tcort/va2epr-tnc/website/va2epr-tnc/va2epr-tnc.png

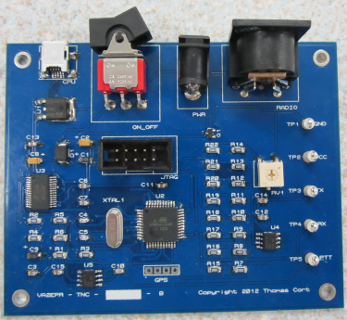
website/va2epr-tnc/va2epr-tnc.png
