tcort/va2epr-tnc/documents/Project Proposal Presentation.pptx

## Terminal Node Controller Final Project

Thomas Cort

[Populated PCB]

## Motivation

- Learning about digital communications.
- Building a device that I will use.
- Sharing my design and software with others.
- Improving on existing technology.
- Passing the course and graduating.

## Outline

- Introduction
- Background Information
- High Level Block Diagram
- Schematic
- Layout
- Milestones
- Statement of Feasibility
- Questions

## Introduction

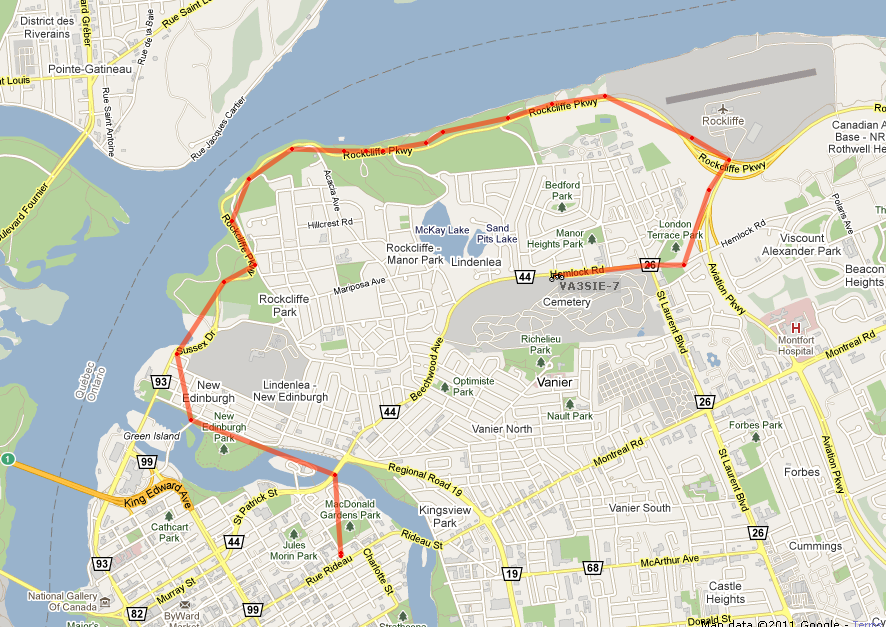
[picture p2: figure]
APRS Map of my bicycle trip...

Position Tracking System

## Background Information

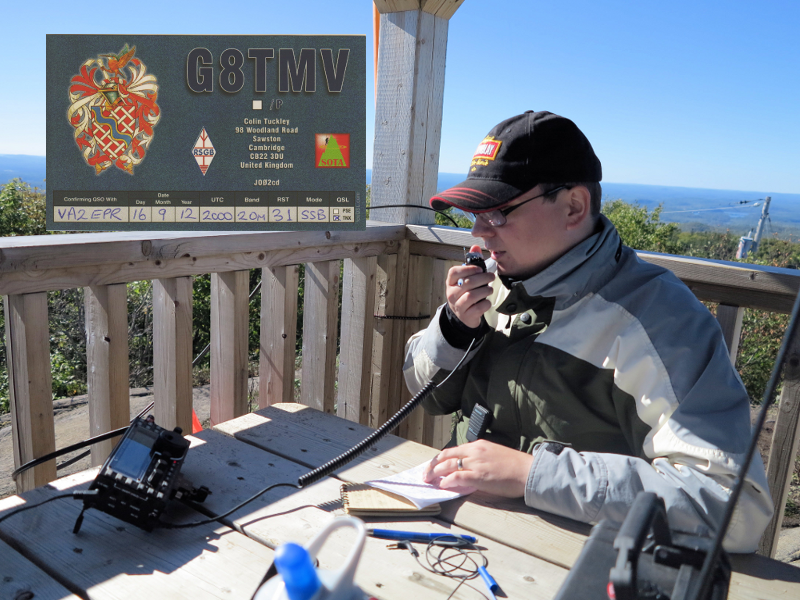
[picture p3: figure]

Amateur Radio

## Background Information

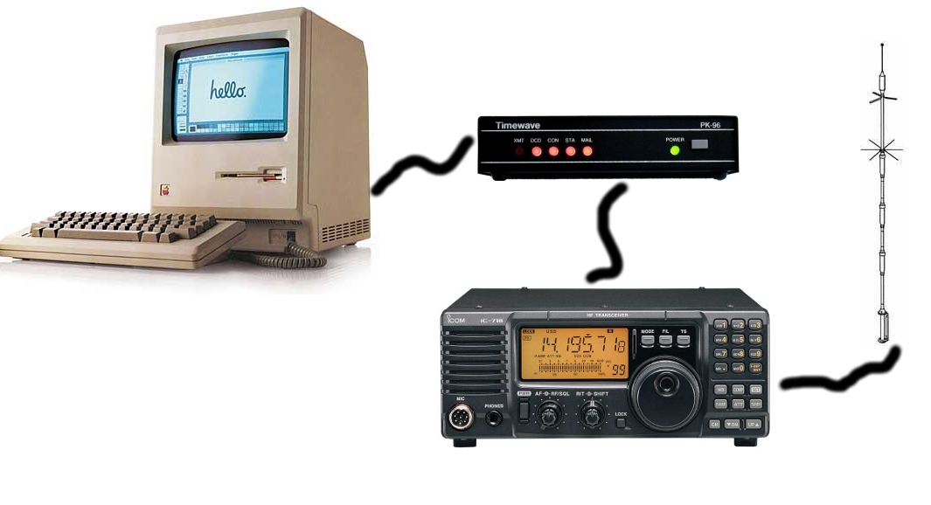
[picture p4: figure]

Packet Radio Terminal Node Controllers

## Background Information

Packet Radio Networks for Position Reporting
- Network – APRS
- Data link – AX.25
- Physical – Bell 202 (1200 Baud AFSK NRZI)

## Goals

- Modern
- Reliable
- Low-cost
- Easy to use
- Open design
- Small form factor
- Portable version

## High Level Block Diagram

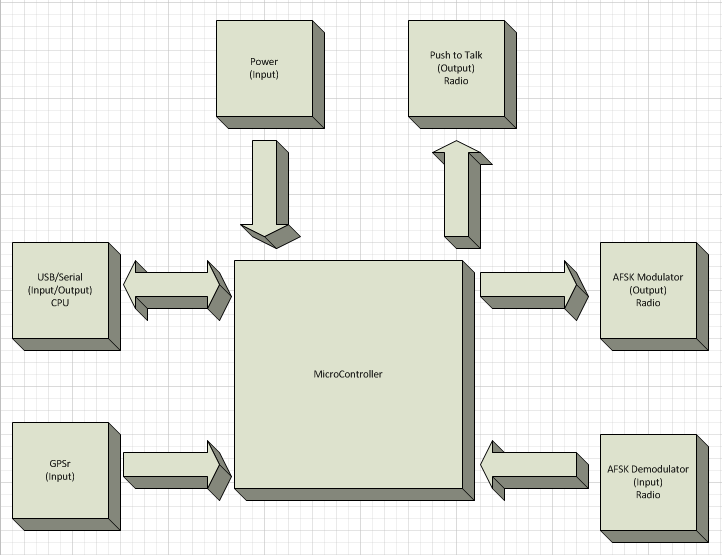
[picture p5: figure]

## Schematic

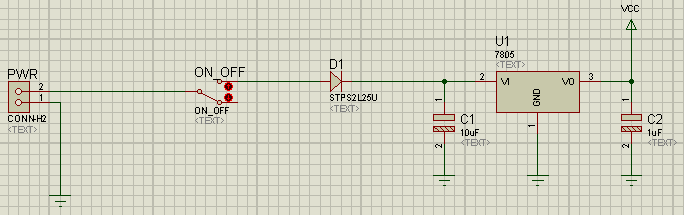
[picture p6: figure]
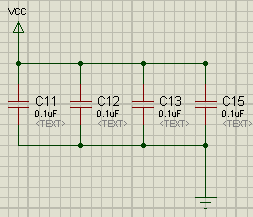
[picture p7: figure]
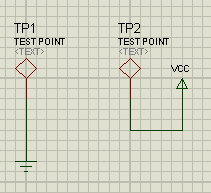
[picture p8: figure]

## Schematic

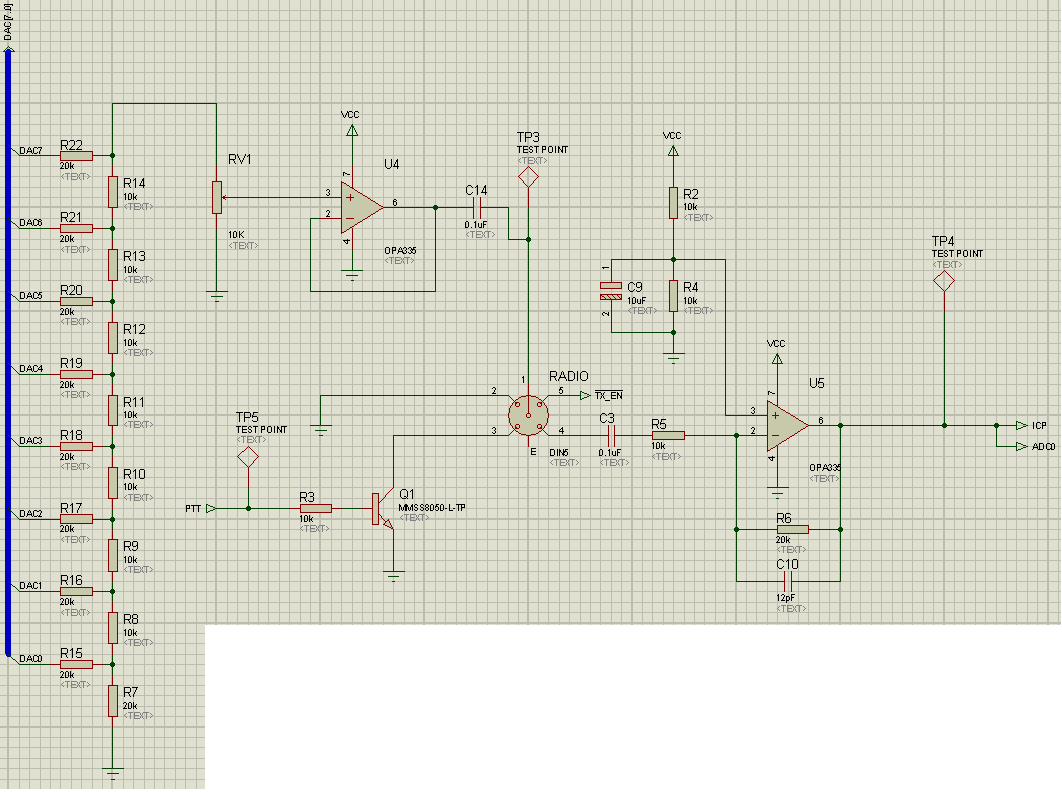
[picture p9: figure]

## Schematic

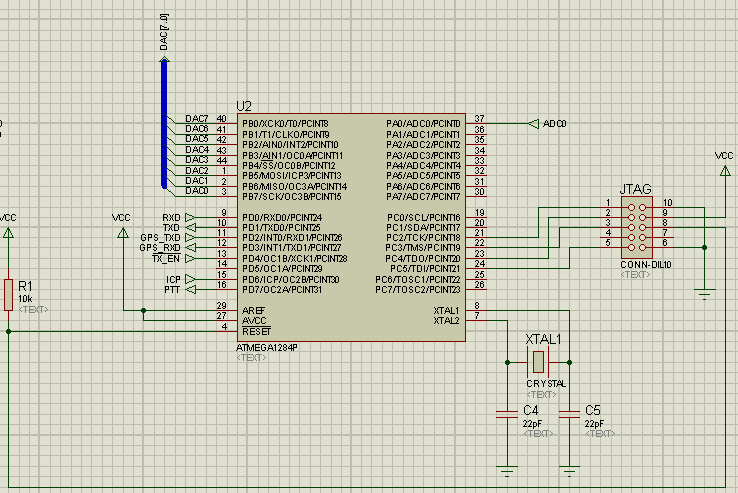
[picture p10: figure]
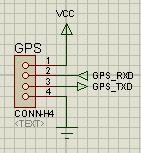
[picture p11: figure]

## Schematic

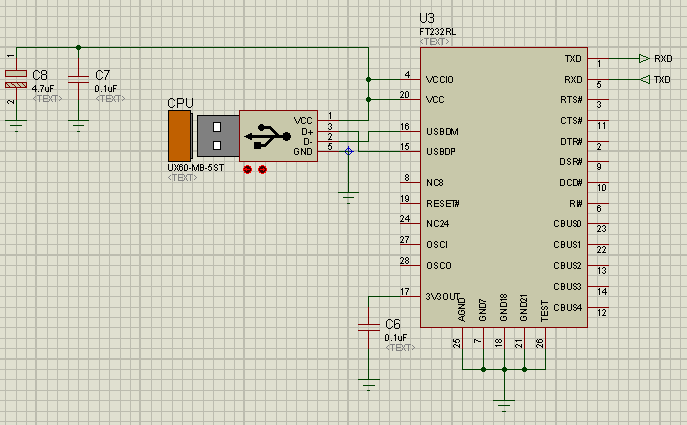
[picture p12: figure]

## Layout

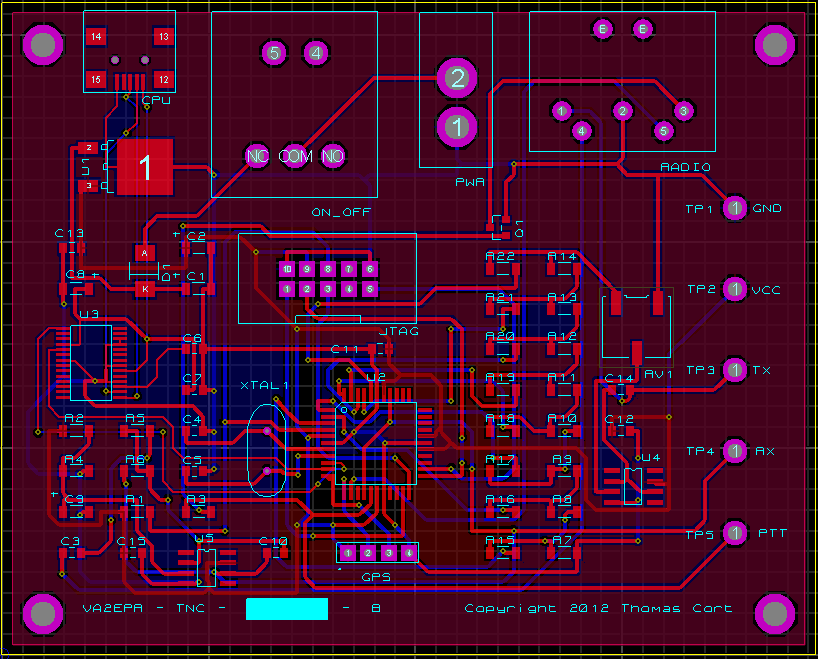
[picture p13: figure]

## Milestones

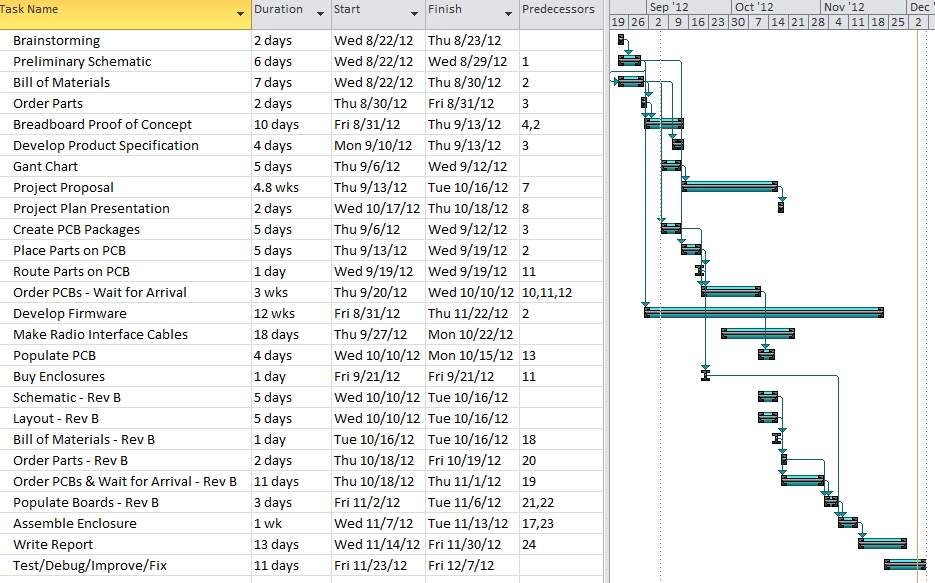
[picture p14: figure]

## Statement of Feasibility

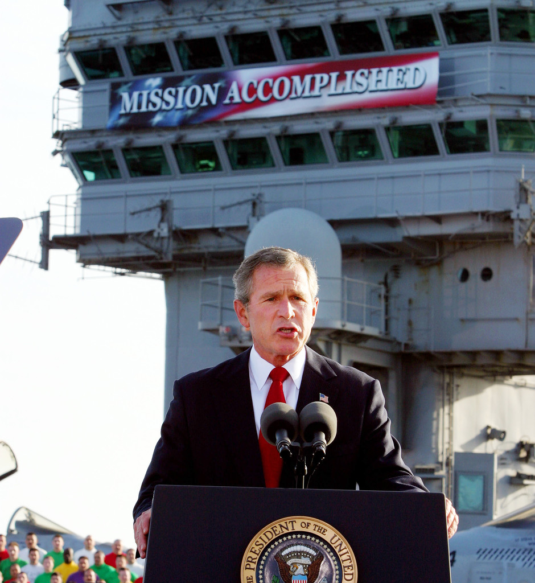
[picture p15: figure]

## Questions?

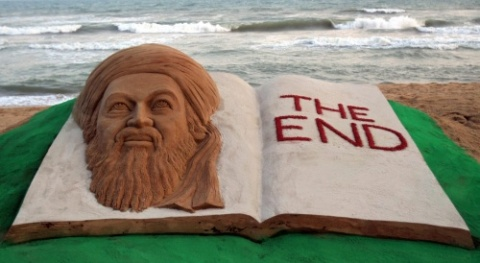
[picture p16: figure]
