tcort/va2epr-tnc/documents/Proposal.odt

Thomas Cort

August 29, 2012

Final Project

I propose developing a Terminal Node Controller (TNC). A TNC is a radio modem; the device is connected to a computer and a radio. Its purpose is to modulate and demodulate signals in order to connect an Amateur Radio operator's computer to packet radio networks. Packet radio networks are useful for keyboard to keyboard communications (chat / instant messaging), reading/posting messages (e-mail / news), emergency communications when normal communications mediums are down, beaconing / receiving position and weather information, and much more. Just within the national capital region there are several weather stations, bulletin board systems, and many other fixed and mobile packet radio nodes. The international space station is even equipped with its own terminal node controller. There are several shortcomings which exist in current terminal node controllers. Improving on those designs is my motivation for this project. The goal of this project is to build a modern reliable low-cost easy to use terminal node controller in a small form factor. I plan on building 2 TNCs, one will be portable. The portable version will have an integrated GPS and periodically beacon its position using the Automatic Packet Reporting System (APRS) protocol. The non-portable version will connect to a computer and perform normal TNC functions (receiving beacons, connecting to other systems, accepting mail, etc).

Terminal Node Controllers operate at the lowest layers of the ISO stack. At the physical level, TNCs implement the Bell 202 Modem standard to send and receive data to and from a radio. The radio itself is responsible for transforming the audio input and output into radio frequency signals. The Bell 202 Modem standard is simply Audio Frequency Shift Keying (AFSK) at 1200-baud with continuous phase using 1200 Hz and 2200 Hz tones. This scheme is also used in North America to transmit telephone caller data over the public switched telephone network to call display systems. In amateur radio, non-return to zero inverted (NRZI) encoding is used. A 1 is encoded as a change in frequency, and a 0 is encoded as no change in frequency. NRZI is used in USB (Mode 1). The interface to the computer is left up to the implementer, but it has traditionally been RS232 (serial). At the data-link layer, computers can send and receive protocol frames to and from the TNC via the KISS protocol, a modified version of Serial Line Internet Protocol (SLIP). The KISS encapsulation is stripped away by the TNC and just the raw frames are sent out over the air. The frames are implemented using the AX.25 protocol. AX.25 is derived from the X.25 protocol with some changes to accommodate radio networks. While in principle AX.25 supports nearly all network layer protocols including Internet Protocol, in practice most communications happen through raw text data sent via AX.25. However, several application layer protocols such as Automatic Packet Report System (APRS) do exist and are in common use. Some TNCs implement AX.25 and can function without a computer by using a dumb terminal. Other TNCs implement just the KISS protocol and let a full featured computer deal with AX.25 and higher level protocols.

The terminal node controllers that I am proposing would include a microcontroller to handle encoding and decoding of the AFSK signals, keying the radio, and interfacing with the computer via the KISS protocol. The computer interface would be RS232 serial. That would enable compatibility with third party software. I would implement AX.25 and APRS. I will also provide a graphical user interface on a PC.

The inputs to the TNC would be audio in (RX) from the radio and RS232 from the computer. The audio signals coming in would be AFSK modulated data. The outputs would be the push to talk (PTT) line to key the transmitter, audio out (TX), and RS232. The TX audio would be used to send AFSK modulated data. The serial interface would be used to communicate with the computer to transfer AX.25 frames and query/adjust settings such as transmit delay, slot time, etc. The portable version would also have an integrated GPS as an input.

In terms of processing, the microcontroller would handle modulating and demodulating the AFSK signals and interface with the computer using the KISS protocol. The PC would handle the data link layer protocol AX.25 and higher level protocols like APRS. The PC would also provide a GUI. The portable version would implement AX.25 and APRS encoding as well as NMEA decoding in order to be able to transmit its location.

The total project could be demoed in the following way: a person could take the portable version and a hand held radio out for a walk in Gatineau park, and the stationary TNC could be connected to a computer and radio in a classroom to display where the person is on a map. The stationary TNC could also be demoed by connecting to a radio BBS or leaving a message on another amateur’s TNC.
