tcort/va2epr-tnc/documents/BuildAndTestProcedure.rtf

Build and Test Procedures
1) Populate all test points: TP1, TP2, TP3, TP4, and TP5.
2) Check for shorts between all test points.
3) Install the USB Mini B connector labelled CPU. Make sure the posts are correctly seated in the holes. Solder 4 corners first, then solder pins. Check for shorts between the 2 outter pins (1 and 5).
4) Connect a computer to the board through the Mini B connector.
5) Measure 5V on pin 20 or pin 4 of U3 or the positive side of C7 or C8.
6) Populate the power section: PWR, ON_OFF, D1, C1, U1, C2
7) Check for shorts between VCC and Ground (TP1 & TP2)
8) Apply 12VDC to PWR, turn ON_OFF to ON, mearsure the voltage across TP1/TP2. It should be 5V. Disconnect power.
9) Populate the PTT section: R3, Q1
11) Populate the decoupling capacitors: C11, C12, C13, C15
12) Populate the RX section: C3, R5, R2, R4, C9, U5, R6, C10
13) Check for shorts between VCC and Ground (TP1 & TP2). Apply a 1Vpp sine wave at 1200Hz to pin 4 of the DIN5 connector (labelled RADIO). Measure the output waveform on TP4 using an oscilloscope. It should show a 4.85Vpp sine wave at 1200 Hz with a 2.5V DC offset.
14) Populate the TX section: R7 to R25, U4, C14
15) Check for shorts between VCC and Ground (TP1 & TP2). If possible, apply a 0V to 5V square wave at 1200 Hz to pin 30 on U2 or the micro side of R22. Measure the output waveform on TP3 using an oscilloscope. It should show a 0.5Vpp square wave at 1200 Hz with no DC offset.
16) Populate the rest of the USB/Serial Interface: C6, C7, C8, U3
17) Populate the microcontroller section: JTAG, U2, R1, XTAL, C4, C5. Hint: pin 1 of JTAG goes to Pin 21 on the micro.
18) Populate any unpopulated parts.
19) Check for shorts between VCC and Ground (TP1 & TP2). Power up briefly. Watch the current meter on the power supply. If there is no smoke, smells, nor heating, then connect a JTAG programmer to the JTAG port and try to program it.
20) Set the fuses
BODLEVEL DISABLED
OCDEN Checked
JTAGEN Checked
SPIEN Checked
BOOTSZ 4096W_F000
SUT_CKSEL FOSC_16KCK_65MS_XOSC_SLOWPWR

21) Program with the test firmware. Check for the expected output at the test points.
