tcort/va2epr-tnc/documents/Diary12.rtf

Final Project Diary #12 Thomas Cort
November 22, 2012
During the preceding week, I assembled two TNC <-> Radio interface cables. I also worked on debugging the firmware for my project. Specifically, I’m trying to fix a problem in the AFSK demodulator where it’s not decoding the data properly. I’ve confirmed that I’m sampling the input signal at the right baud rate by toggling an output pin every time I sample the input. I’ve also double checked my math and the settings for input capture, and I looked at the input to the ICP pin on an oscilloscope. Everything seems okay.
During the next week, I will continue to work on the firmware. I’m going to think over the problem I’m having, and look at some code that someone else wrote to implement a zero-cross detector based AFSK decoder. If that doesn’t yield any good results, I may implement a software based zero cross detector using the ADC.
