tcort/va2epr-tnc/documents/Diary10.rtf

Final Project Diary #10 Thomas Cort
November 8, 2012
During the preceding week, I received my Rev B PCBs. I populated one board and most of another. I ran out of parts for the 2nd. I've ordered additional parts from Digi-key as well as some molex connectors to connect the GPS module to the PCB. I did some testing on the board that I did finish populating. The regulated voltage is a solid 5.00V. I was able to program the board with the AVR Dragon, setting fuses and writing to flash and eeprom. I tested the UART and the AFSK output. I realized that the DAC was wired backwards (LSB first instead of MSB first), so I had to recompute the sine wave table, reversing the bits in each entry. I also drilled a few holes in an enclosure. Lastly, I researched how to demodulate the AFSK signal in software.
During the next week, I will finish populating the second PCB. I will build TNC <-> Radio interface cables using new DIN5 connectors I got from Digi-key. I will also finish drilling the enclosures. After testing the Rev B hardware, I will continue to work on the software and firmware. For the software, I’ll finish up the console class. For the firmware, I’m going to debug my AFSK receive code (or re-write it).
