tcort/va2epr-tnc/documents/Diary11.rtf

Final Project Diary #11 Thomas Cort
November 15, 2012
During the preceding week, I ordered the parts I needed from Digi-key to finish populating the 2nd PCB. I also ordered connectors, sockets, pins, and crimpers to connect the GPS to one of the boards. I tested the 2nd PCB, and there were no assembly errors. In addition, I did a lot of work on the enclosures. I drilled holes to mount the boards, and I made large cut outs so that the power switch and all of the connectors would be accessible from outside the case. Finally, I mounted the boards in the enclosures and did some additional tests (for example, checking that the GPS could obtain a lock and report its position).
During the next week, I will finish building the TNC <-> Radio interface cables using new DIN5 connectors I got from Digi-key. I had worked on one last week, but I made an error. When those are complete, I will be able to do more tests of the firmware and work towards finishing the firmware.
