tcort/va2epr-tnc/documents/Diary9.rtf

Final Project Diary #9 Thomas Cort
November 1, 2012
During the preceding week, I did some work on the GUI software. I worked on that because I need to be able to send “unprintable characters” (e.g. 0xff) from the PC via the USB interface as well as receiver data on the PC and look at it in HEX and ASCII. I couldn’t really find a terminal program that allowed me to do those things, so I began working on a “Console” class that uses the SerialPort classes I wrote last week to present a display that allows a user to input data and view the received data. This will enable me to do a better job testing and debugging the firmware code. It will make things like testing the EEPROM read/write possible. Also, I did a proof of concept for the maps that my GUI will use to display the position of the portable unit. I used the OpenStreetMap’s OpenLayers Javascript library in conjunction with a QWebView widget and some custom HTML, Javascript, and CSS to create a map widget. I also learned how to call Javascript functions from C++; this will be used to manage the position markers on the map. Lastly, I revised my project proposal report and distributed it to the class.
During the next week, I will populate my new printed circuit boards. The Rev B boards should arrive tomorrow. I will build TNC <-> Radio interface cables using new DIN5 connectors I got from Digi-key. After testing the Rev B hardware, I will continue to work on the software and firmware. For the software, I’ll finish up the console class. For the firmware, I’m going to debug my AFSK receive code. It’s written but it doesn’t really work except for sometimes finding the AX.25 frame delimiter flag. I am working towards being able to transmit a position report as well. For that, I will need to finish implementing AFSK TX.
