tcort/va2epr-tnc/documents/Diary8.rtf

Final Project Diary #8 Thomas Cort
October 25, 2012
During the preceding week, I ordered Rev B PCBs from iTead Studio. They shipped out today. I ordered the additional parts from Digi-key, potentiometers and better DIN5 connectors. Those parts have arrived. I worked on the build system for the firmware too. I added makefile targets to build an eeprom image, write the eeprom, read the fuses, and write the fuses. Additionally, I wrote some C++ classes for doing serial communications in Linux and Windows. I tested receiving data from the micro on Linux and Windows.
During the next week, I will continue to work on the firmware. I’m going to debug my AFSK receive code. It’s written but it doesn’t really work except for sometimes finding the AX.25 frame delimiter flag. I am working towards being able to transmit a position report as well. For that, I will need to finish implementing AFSK TX.
