tcort/va2epr-tnc/documents/Diary7.rtf

Final Project Diary #7 Thomas Cort
October 18, 2012
During the preceding week, I completed the project proposal report document and the project proposal presentation slides. I did additional testing of the circuits on the PCB. I also connected the GPS receiver to the board. I echoed the output from the GPS to the other UART, and I observed the output on a PC. I researched the APRS protocol to see what information I will need to encode for position report packets. I did some work on the firmware. I implemented checksum checking for NMEA 0183 (the data format for stuff coming out of the GPS). I also wrote a function to extract the coordinates from GGA and RMC NMEA sentences. I have an AX.25 checksum function written too. Additionally, I did some layout work on my Rev B PCB. I’ve made some improvements and fixes. Lastly, I researched connectors for the GPS module as I noticed the thin wires probably wouldn’t hold up for very long if directly soldered to the board with no strain relief.
During the next week, I will order Rev B PCBs from iTead Studio. I will also order a few additional parts from Digi-key as I will be short on some parts and have a few new parts to buy (potentiometers and better DIN5 connectors). I will continue to work on the firmware. I am working toward being able to transmit a position report. I will need to develop stripped down implementations of AX.25 and APRS for that as well as finish implementing AFSK TX.
