tcort/va2epr-tnc/documents/Diary6.rtf

Final Project Diary #6 Thomas Cort
October 11, 2012
During the preceding week, I completed the first draft of the Project Proposal Report. I also received the printed circuit boards from iTead Studio. I populated a board with components and performed some tests. I discovered an issue with the voltage regulator package, the pinout is wrong. I was able to leave off the power supply section and populate the rest of the board, supplying power through the VCC/GND test points from a bench supply. Here is a summary of the testing I’ve done: plugged in a USB cable and the computer detected the FTDI chip, applied a signal to the RX input and looked at the RX test point (it looked good), I used the JTAG port to read/program the chip and fuses, I tested the serial interface, and I also tested the DAC output. During the assembly and test process I identified other things that can be improved on the board. For example, the silk screen for the polarized capacitors lacks polarity indicators. I’ve started a document to enumerate the changes I have in mind for revision B.
In my previous journal entry I neglected to mention that I had worked on the radio interface cables. That didn’t go so well. I chose the DIN5 connectors based on price, and it turns out that they were garbage. The plastic that holds the pins in place has a very low melting point, and the pins are so big they act like heat sinks which causes the plastic to melt before the pin is hot enough for the solder to flow. I’m planning on purchasing higher quality DIN5 connectors (or just buying full cable assemblies) in my next Digi-key order.
During the next week, I will finalize the project proposal report document and create the presentation slides. I will continue testing the PCB. I want to make sure I capture all of the mistakes from the first revision before spinning another board. Then, I will make a revision B board and order new PCBs and a few parts.
