tcort/va2epr-tnc/documents/Diary5.rtf

Final Project Diary #5 Thomas Cort
October 4, 2012
During the preceding week, I worked mainly on documentation and a bit on firmware. I’m nearly finished the Project Proposal Report. I also am preparing for when my PCBs arrive. I wrote a build and test procedure for populating the board. Lastly, I worked on ‘test’ firmware that exercises the different circuits. It will output a specific pattern on the TX pin, toggle the PTT pin on and off periodically, send a test message through USART, and output the frequency of the signal being received on the RX pin.
During the next week, I will be testing the GPS UART interface. I will also work on debugging the firmware for receiving data. I will finish the project proposal report and presentation. I will also finish the test firmware while waiting for my PCBs to arrive.
