tcort/va2epr-tnc/documents/Diary4.rtf

Final Project Diary #4 Thomas Cort
September 27, 2012
During the preceding week, I did more work on the firmware. I developed code to decode the incoming AFSK signals and output the bytes through the UART interface using the KISS protocol. I tested the code and found that it isn't working as expected. Some bytes are decoded correctly, but a lot aren't. From the testing I've done it's either a timing issue, a byte order issue, or my tollerances/thresholds for determining when a specific tone is present are too tight. My PCBs have shipped from iTead Studio. I also ordered enclosures from TenTec; those are on the way as well. Finally, I wrote an additional 10 pages of the project specification document.
During the next week, I will be testing the GPS UART interface. I will also work on debugging the firmware for receiving data. I will continue work on the a project plan document, hopefully finishing it. Finally, I will come up with a test plan / assembly procedure for my PCB so that if there are errors, I know early (i.e. before everything has been soldered) and don't fry any chips.
