tcort/va2epr-tnc/documents/Diary3.rtf

Final Project Diary #3 Thomas Cort
September 20, 2012
During the preceding week, I did some work on the firmware. I implemented CSMA/CA as well as persistent configuration storage with EEPROM. I tested the output voltage of a Kenwood TH-22AT radio and researched interfacing with the radio to ensure that it will be compatible with my project. I also completed my PCB layout and ordered the boards from iTead Studio. In addition, I wrote the introduction section of the project specification document. Finally, I updated my Gantt chart to reflect my progress.
During the next week, I plan on testing the UART sections of my circuit; I will be testing the GPS UART interface and computer UART interface via the FT232RL chip. I will also work on the firmware for receiving data. I will continue work on the a project plan document. Lastly, I will go shopping for enclosures.
