tcort/va2epr-tnc/documents/Diary2.rtf

Final Project Diary #2 Thomas Cort
September 12, 2012
During the preceding week, I created a Bill of Materials (BOM) in Proteus ISIS. The BOM is complete with Digi-key part numbers and costs which are totaled at the bottom. I assigned packages to parts as well. I also placed parts in Proteus ARES and created some footprints. I'm almost done the PCB layout, mounting holes and routing remain (the autorouter can route everything in it's current state). After that I will verify pinouts against the datasheets and check footprints with a print-out and actual parts. I continued bread boarding and developing firmware. I tested some of the main sections of the circuit. I was able to use input capture to determine an incoming audio signal’s frequency and turn on one LED for 1200 Hz and another for 2200 Hz. I was also able to generate sine waves at those two frequencies, though I may need to increase the number of samples to get a better approximation of a sine wave. Additionally, I tested the transistor I plan on using to control the Push-to-Talk (PTT) line by using it to turn on and off an LED. Lastly, I developed a Gant Chart as part of my project plan.
During the next week, I plan on testing the UART sections of my circuit; I will be testing the GPS UART interface and computer UART interface via the FT232RL chip. Assuming the hardware is working as expected, I will complete my PCB layout. I will also work on the product specification document, a project plan document, and a project plan presentation. Lastly, I will verify the input/output voltage levels of several radios to ensure that my interface will work correctly.
