tcort/va2epr-tnc/documents/Diary1.rtf

Final Project Diary #1 Thomas Cort
September 5, 2012
During the preceding week, I completed the first draft of my schematic. I ordered the parts needed for bread boarding the circuit as well as parts and tools for the final board. I also ordered materials for making cables to interface with a radio. The parts arrived, and I began bread boarding parts of the circuit. I soldered some SMT only parts to breakout boards. I got the power stage built, and I wired up the microcontroller. I was able to set the fuses and program it with an AVR Dragon in AVR Studio. I developed some sine wave generation code as well as a utility to pre-compute sine wave tables. I setup an R-2R ladder on the breadboard to test it. The code needs some debugging as I'm not getting any output yet.
During the next week, I plan on testing more sections of my circuit. After completing a proof of concept (can generate sine waves, can capture a sine wave, can turn on/off a transistor, etc.), I will finalize the schematic and bill of materials. Then, I’ll move on to the PCB layout. I will also develop a project plan during this time.
