tcort/va2epr-tnc/documents/Diary15.rtf

Final Project Diary #15 Thomas Cort
January 29, 2012
During the preceding week, I went through the firmware squashing bugs and adding comments. I also added a feature to allow the PC to retrieve the configuration settings from my device. I did some work on the PC software as well. I’ve made some improvements to the console, and I made a few updates to correspond with some changes I made to the firmware.
During the next week, I will work on finishing up the firmware that will be used for the base station (i.e. without APRS and AX.25), and I will do some testing. For the testing, I need to work on the PC software. I need to connect my SerialPort implementation to code that will process the data. After that I’ll begin testing with pre-recorded signals. If the code works, I’ll move on to the firmware for the portable version. For that I need to implement a minimal AX.25 and APRS stack.
