tcort/va2epr-tnc/documents/Diary16.rtf

Final Project Diary #16 Thomas Cort
February 5, 2013
During the preceding week, I did some research and found some software libraries that will make my life easier. The Finnish APRS Parser library will allow me to parse raw packets on the PC that come from my hardware. I also found how to configure the kernel device driver for KISS TNCs and how to use the AX.25 library. In addition, I decided to use QextSerialPort for serial port communications from Qt. I had originally written my own library, but QextSerialPort has many more features and is much more flexible. I have done the initial work to convert my PC software to use QextSerialPort, but more work remains on that front. I also did some clean-up of the console class, added a splash screen when the program is loading, and added doxygen documentation generation to the build system.
During the next week, I will work on finishing up the firmware that will be used for the base station (i.e. without APRS and AX.25), and I will do some testing. For the testing, I need to work on the PC software. I need to put code behind the buttons that read/write the configuration information to my hardware, and I need to finish up the code that displays the serial data in the GUI’s console. After that I’ll begin testing with pre-recorded signals. If the code works, I’ll move on to the firmware for the portable version. For that I need to implement a minimal AX.25 and APRS stack.
