tcort/va2epr-tnc/documents/Diary17.rtf

Final Project Diary #17 Thomas Cort
February 12, 2013
During the preceding week, I did more work on the GUI software for the PC. I wrote the code that backs the Connect and Disconnect buttons so that the serial port can connect to my hardware. I did some code clean up and some commenting. I also added Tool Tips to the fields in the configuration form. Lastly, I wrote some Javascript to add markers to the map. I would have done some testing of the serial port communications and implement read/write functions, but we only had half of a class on Tuesday because of some promotional thing for the college.
During the next week, I will work on finishing up the firmware that will be used for the base station (i.e. without APRS and AX.25), and I will do some testing. For the testing, I need to implement read and write for the serial port in the PC software. After that I’ll begin testing with pre-recorded signals. If the code works, I’ll move on to the firmware for the portable version. For that I need to implement a minimal AX.25 and APRS stack.
