tcort/va2epr-tnc/documents/Diary18.rtf

Final Project Diary #18 Thomas Cort
February 19, 2013
During the preceding week, I worked on some TODO items that were still left in the firmware. Most notably, I added some functions to get the time from the GPS and compare the time to another time. This will be used in the portable version to determine whether it’s time to beacon again or wait. I also worked on the transmit code and buffer code. I cleaned up some code in the GUI, implemented an interface to write to the serial port, added code to display the bytes read from the serial port, and corrected some minor typos. I was successfully able to connect to my hardware from my GUI.
During the next week, I will work on the configuration part of the GUI (i.e. the part that reads/writes configuration data from/to my hardware). I will test the code with various values to make sure that it works and that the settings persist after power cycling the hardware. After that’s working, I will do testing of the AFSK transmit and receive code.
