tcort/va2epr-tnc/documents/Diary13.rtf

Final Project Diary #13 Thomas Cort
November 29, 2012
During the preceding week, I continued to work on the firmware for my project. It’s over 2000 lines of code so far! The AFSK receive code isn’t done yet, but it’s improving in accuracy. I’ve started working on the AFSK transmit code. I can vary the output signal frequency while keeping the phase continuous; the signal looks good on the scope. Lastly, I wrote and tested a function to detect if the GPS is connected (i.e. if the device is configured as the portable version or the base station version).
During the next week, I will continue to work on the firmware. The following is a list of features that need to be implemented for the firmware to be feature complete:
• AFSK TX
o I need to work on the TX buffer management code
• AFSK RX
o I need to finish debugging the RX code
• Obtaining position information
o GPS USART is working, and I’ve written/tested a NMEA parser.
o I need to write code to buffer the incoming data and call the parser.
• Ability to TX position reports
o I need to implement a small part of AX.25 for framing
▪ So far I’ve written the CRC function
o I need to implement a small part of APRS
I probably won’t finish everything in the coming week, but I’ll continue to work on the code over the christmas break.
