tcort/va2epr-tnc/documents/Diary14.rtf

Final Project Diary #14 Thomas Cort
January 22, 2012
During the preceding week, I went through my project files to take stock of my current progress. Then, I updated my project plan and Gantt chart. I began working on finishing up the firmware. I think I have the AFSK RX code fixed; I just need to test it with real AFSK signals. I also wrote buffer management code for grabbing data off of the GPS.
During the next week, I will work on finishing up the firmware that will be used for the base station (i.e. without APRS and AX.25). For that, I need to work on the TX buffer management code. After that I’ll begin testing with pre-recorded signals. If the code works, I’ll move on to the firmware for the portable version. For that I need to implement a minimal AX.25 and APRS stack.
