tcort/va2epr-tnc/hardware/VA2EPR-TNC.PDF

## PWR

## ON_OFF

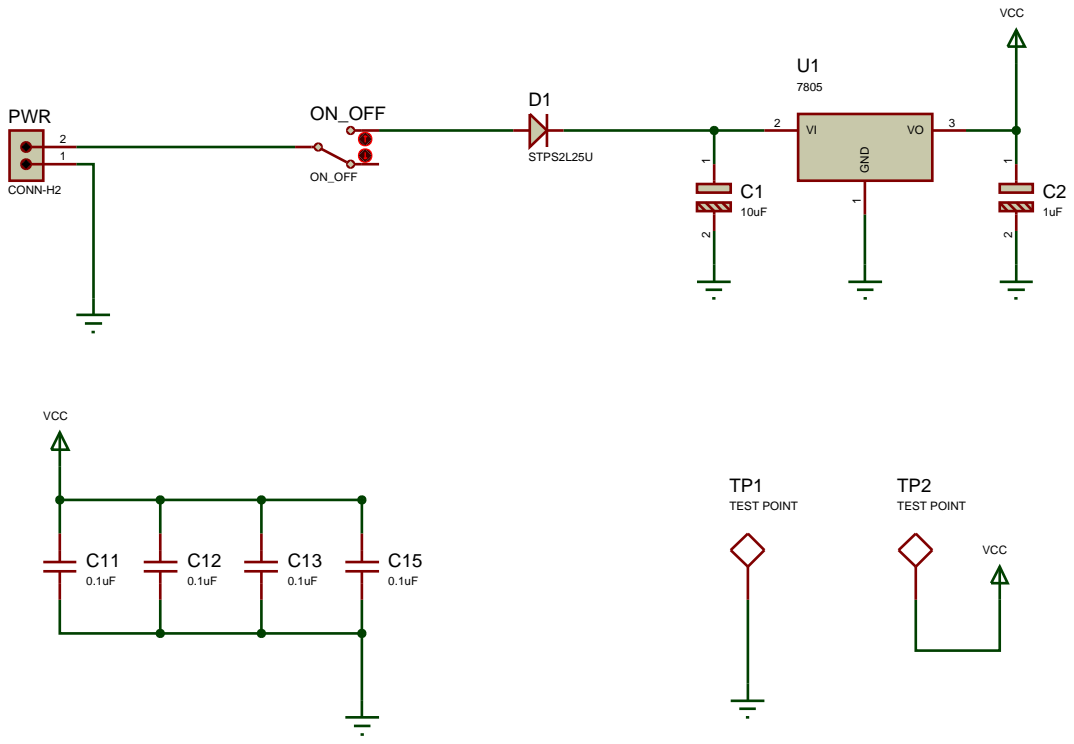
[picture p27: page 1]

R2

R14

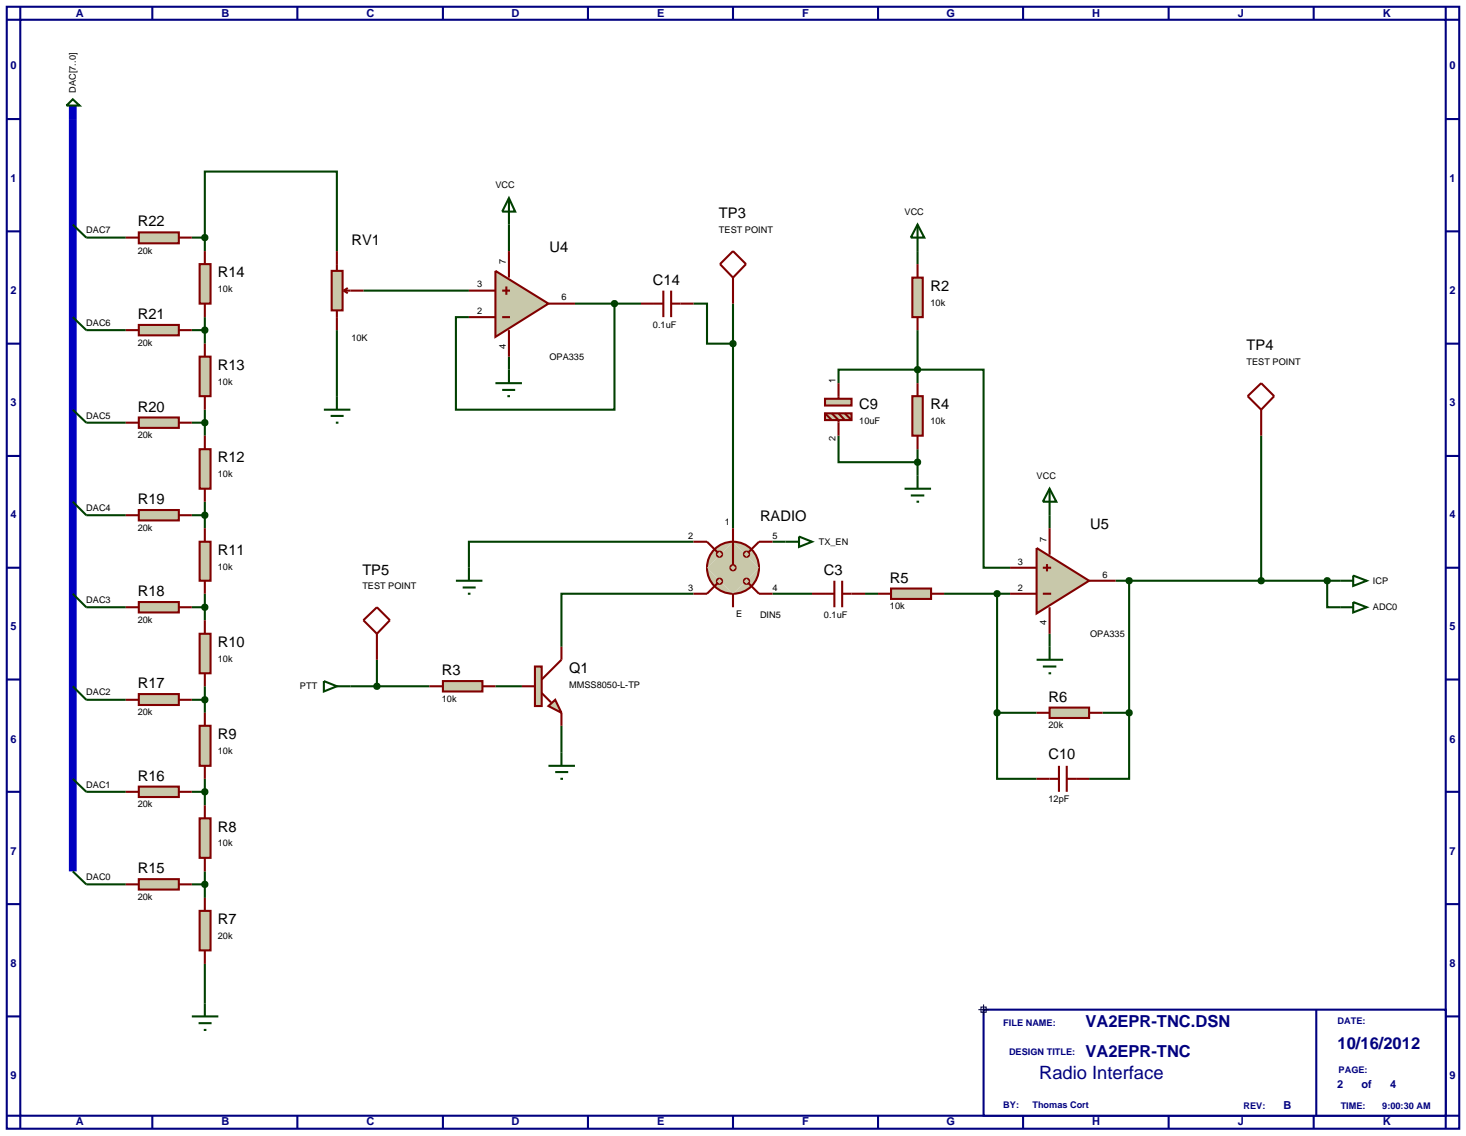
[picture p28: page 2]

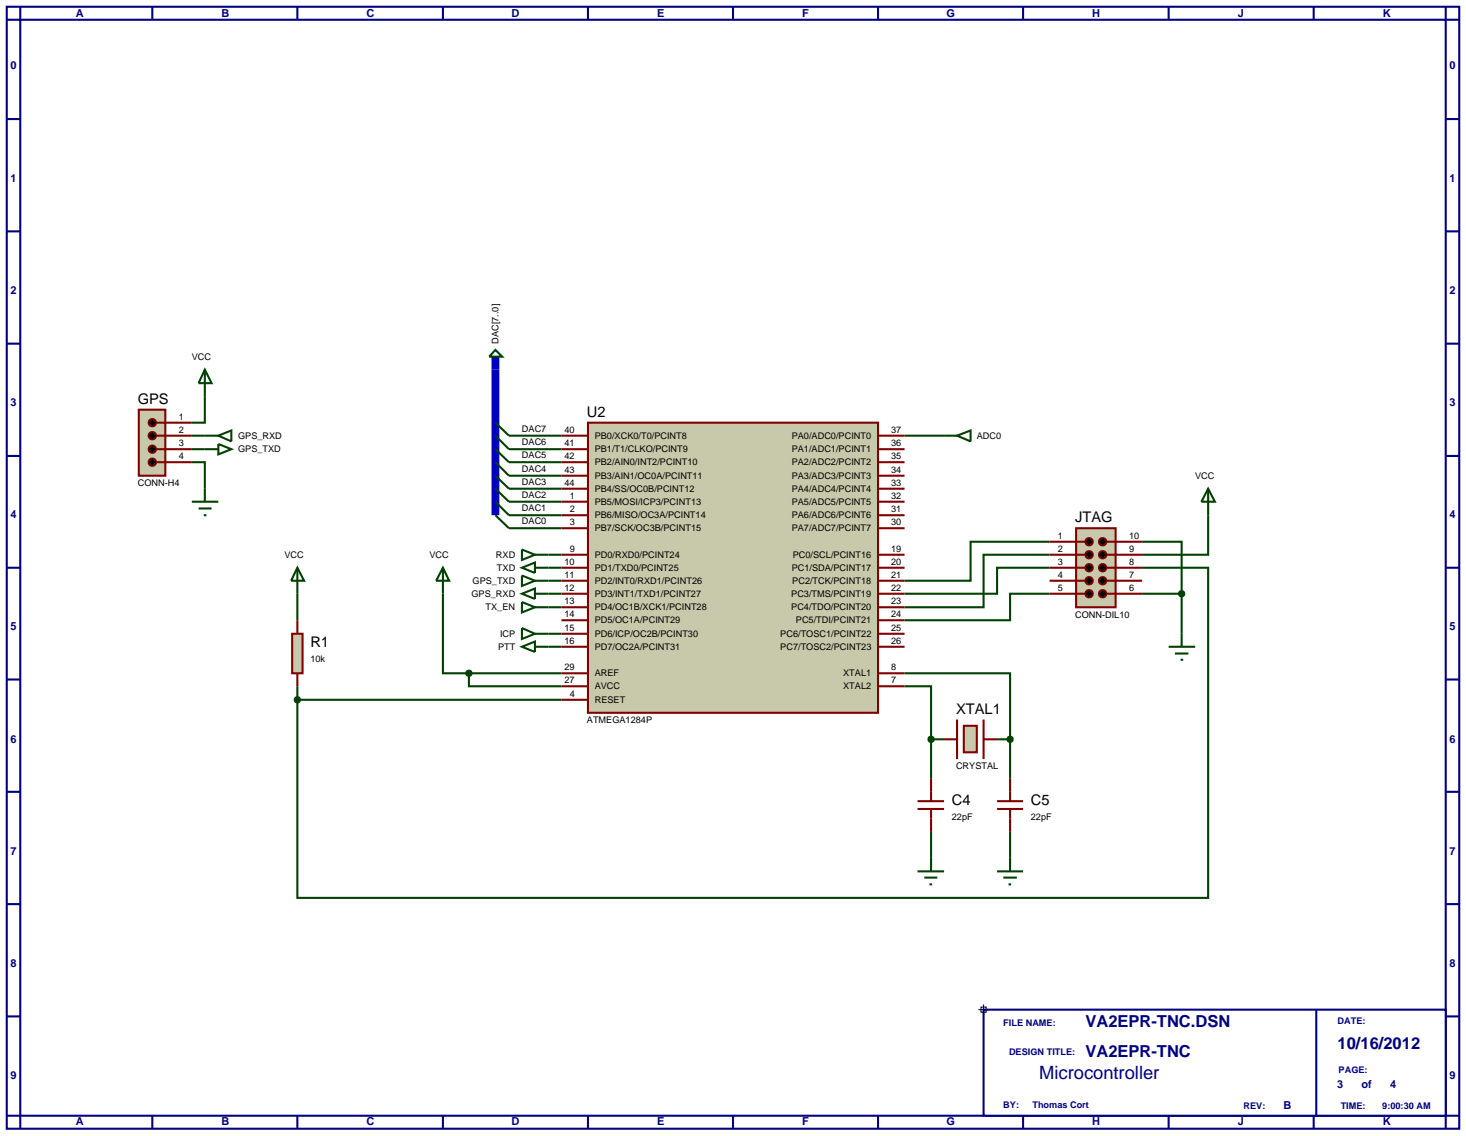
[picture p29: page 3]
FILE NAME:; DATE:; VA2EPR-TNC.DSN; Microcontroller; DAC7 DAC6 DAC5 DAC4 DAC3 DAC2 DAC1 DAC0; PC6/TOSC1/PCINT22; PC5/TDI/PCINT21; PC4/TDO/PCINT20; PC3/TMS/PCINT19; PC2/TCK/PCINT18; PC1/SDA/PCINT17; PC0/SCL/PCINT16; AVCC 27; AREF 29; PC7/TOSC2/PCINT23; PA6/ADC6/PCINT6; PA5/ADC5/PCINT5; PA4/ADC4/PCINT4; PA3/ADC3/PCINT3; PA2/ADC2/PCINT2; PA1/ADC1/PCINT1; PA0/ADC0/PCINT0; PA7/ADC7/PCINT7; PB6/MISO/OC3A/PCINT14 2; PB5/MOSI/ICP3/PCINT13 1; PB4/SS/OC0B/PCINT12 44; PB3/AIN1/OC0A/PCINT11 43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

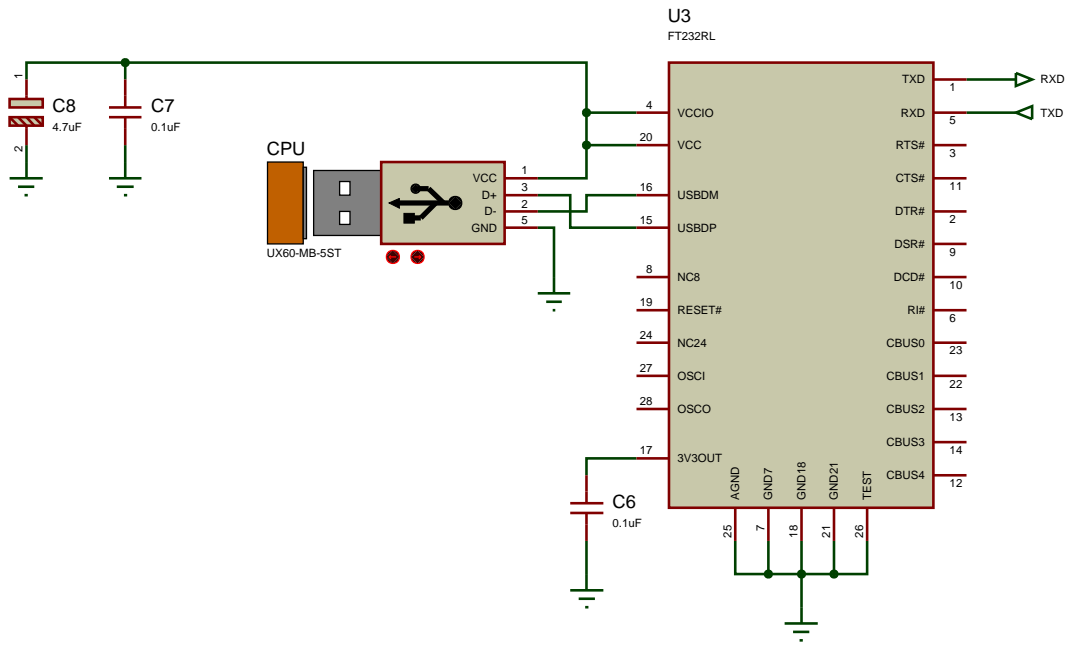
[picture p30: page 4]
FILE NAME:; DATE:; VA2EPR-TNC.DSN; Computer Interface; VCC; GND; CPU; VCCIO 4; VCC 20; USBDM 16; USBDP 15; RESET# 19; OSCI 27; OSCO 28; 3V3OUT 17 AGND 25; GND7; GND18 18; GND21 21; TEST 26; TXD; RXD; RTS#; CTS#; DTR#; DSR#; DCD#; CBUS0; CBUS1; CBUS2; CBUS3; CBUS4
