tcort/va2epr-tnc/(list of files, drawings)

Other design files:
hardware/va2epr-tnc-cables.DSN
hardware/VA2EPR-TNC.DSN
hardware/VA2EPR-TNC.LYT
website/va2epr-tnc/VA2EPR-TNC.DSN
website/va2epr-tnc/VA2EPR-TNC.LYT
