tcort/va2epr-tnc/firmware/gps.c

/*
 * va2epr-tnc firmware - terminal node controller firmware for va2epr-tnc
 * Copyright (C) 2012, 2013 Thomas Cort <linuxgeek@gmail.com>
 *
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
 * You should have received a copy of the GNU General Public License
 * along with this program.  If not, see <http://www.gnu.org/licenses/>.
 */

/*
 * The GPS module being used in this project outputs data according to
 * NMEA0183 V2.2. It supports the following sentences:
 *
 *   GGA ~ Global Positioning System Fix Data. Time, Position and fix related data for a GPS receiver
 *   GSV ~ Satellites in view
 *   GSA ~ GPS DOP and active satellites
 *   RMC ~ Recommended Minimum Navigation Information
 *   VTG ~ Track Made Good and Ground Speed (optional)
 *   GLL ~ Geographic Position Latitude/Longitude (optional)
 *
 * From what I've read, the GPS module continuously outputs
 * GPGGA, GPGSA, GPGSV, and GPRMC sentences in NMEA mode. From what I observed,
 * not all sentences appear all of the time. For example, GPGSV isn't sent
 * when no satellites are in view.
 *
 *
 * When I plugged it in for the first time I got this about every second...
 *
 *   $GPGGA,000425.035,0000.0000,N,00000.0000,E,0,00,,0.0,M,0.0,M,,0000*46
 *   $GPGSA,A,1,,,,,,,,,,,,,,,*1E
 *   $GPGSV,1,1,00*79
 *   $GPRMC,000425.035,V,0000.0000,N,00000.0000,E,,,150209,,,N*7C
 *
 * When no satellites were in view, there were no $GPGSV sentences.
 *
 * Coordinates use the WGS 84 DATUM
 *
 * Ports and Peripherals Used
 * --------------------------
 *
 * USART1 (Connected to the GPS)
 *
 * PD2 (RXD)
 * PD3 (TXD)
 */

#include <avr/io.h>
#include <avr/interrupt.h>
#include <string.h>
#include <util/delay.h>

#include "uart.h"
#include "gps.h"
#include "nmea.h"

/* Size of the receive buffer (should be big enough for 1 sentence) */
#define GPS_BUFFER_SIZE (128)

/*
 * Input buffer for GPS data. It should hold an NMEA sentence.
 */
unsigned char gps_buffer[GPS_BUFFER_SIZE];

/*
 * Current location in the gps_buffer to put the next byte.
 */
unsigned char gps_buffer_index;

/*
 * Coordinates
 */
struct nmea_coordinates coords;

/*
 * Type of the sentence stored in gps_buffer
 */
enum nmea_sentence_type gps_buffer_type;

/*
 * Simple State Machine for getting an NMEA sentence from a stream.
 *
 *  SEARCHING - looking for start of sentence '$'
 *  LOADING - copying data into gps_buffer_type[]
 *  DONE - gps_buffer_type[] has a sentence in it, ignore input until manual state change.
 */
enum gps_state { SEARCHING = 0, LOADING = 1, DONE = 2 } current_state;

/*
 * Initialize the GPS interface
 */
void gps_init(void) {

	/* 4800 baud */
	UBRR1H = (GPS_UBRR_VAL >> 8);
	UBRR1L = (GPS_UBRR_VAL & 0xFF);

	UCSR1C |= (1 << UCSZ10) | (1 << UCSZ11);

	current_state = DONE;
}

/*
 * Enable the GPS receiver (i.e. turn on UART1 TX / RX / RX Interrupt)
 */
void gps_enable(void) {

	memset(&coords, '\0', sizeof(struct nmea_coordinates));

	/* Enable RX/TX and RX interrupt */
	UCSR1B |= ((1 <<  RXEN1) | (1 << TXEN1) | (1<<RXCIE0));

	current_state = SEARCHING;
}

/*
 * Simple test to see if the GPS is plugged in.
 * The GPS spits out data every second, so this function just
 * enables UART1, waits a couple of seconds, and sees if there
 * was any data received on UART1.
 */
char gps_is_connected(void) {

	/* state of the GPS (-1 = unsure, 0 = not connected, 1 = connected) */
	static unsigned int status = -1;

	/* index */
	unsigned int x = 0;

	/* temp variable for read USART data */
	unsigned char c;

	/* number of bytes read from USART */
	unsigned char count = 0;

	if (status == -1) {

		status = 0;

		/* Turn on USART */
		UCSR1B |= ((1 <<  RXEN1) | (1 << TXEN1));

		for (x = 0; x < 2048; x++) {

			if (UCSR1A & (1<<RXC1)) {

				c = UDR1;
				c = c; /* avoid unused variable warning */

				count++;

				/*
				 * if I can read more than 16 bytes in 2
				 * seconds, then the GPS is probably
				 * connected and sending data.
				 */
				if (count >= 16) {
					status = 1;
					break;
				}
			}

			_delay_ms(1);

		}

		/* Turn OFF USART */
		UCSR1B &= ~((1 <<  RXEN1) | (1 << TXEN1));

	}

	return status;
}

/*
 * Disable the GPS (UART1 TX / RX / RX Interrupt
 */
void gps_disable(void) {

	current_state = DONE;

	/* Disable RX/TX and RX interrupt */
	UCSR1B &= ~((1 <<  RXEN1) | (1 << TXEN1) | (1<<RXCIE0));

}

/*
 * Simple accessor for coordinates.
 */
struct nmea_coordinates *gps_get_coords(void) {

	return &coords;
}

/*
 * Receive Data from the GPS
 *
 * Tries to find a NMEA sentence "$ ... \r\n" in the
 * stream of incoming bytes. Once one is found, the
 * sentence is validated and then it tries to extract
 * the coordinates.
 */
ISR(USART1_RX_vect) {

	static unsigned char c = 0x00;

	/* Read from UART */
	c = UDR1;

	switch (current_state) {

		case SEARCHING:
			if (c == '$') {

				current_state = LOADING;
				gps_buffer_index = 0;

			}

			/* fall through */

		case LOADING:

			if (c == '\r' || c == '\n') {

				current_state = DONE;

				if (nmea_validate(gps_buffer)) {


					if (nmea_extract_coordinates(gps_buffer, &coords) != 0) {

						/* couldn't parse, try finding another sentence that is valid */
						current_state = SEARCHING;
					}

				} else {

					/* invalid checksum, try finding another sentence that is valid */
					current_state = SEARCHING;
				}

			} else {

				gps_buffer[gps_buffer_index] = c;
				gps_buffer_index = (gps_buffer_index + 1) & 0x7f; /* prevent overflow */
			}

			gps_buffer[gps_buffer_index] = '\0'; /* ensure null terminated string */

			if (gps_buffer_index == 6 && !(!strcmp("$GPGGA", (const char *) gps_buffer) || !strcmp("$GPRMC", (const char *) gps_buffer))) {

				/*
				 * If the sentence isn't GPGGA nor GPRMC, then it doesn't contain coords.
				 * The parser can only parse coordinates, so we skip all other sentences
				 * and wait for a GPGGA or GPRMC sentence.
				 */
				current_state = SEARCHING;
			}

			break;

		case DONE:
		default:
			break;

	}
}
