tcort/va2epr-tnc/(commit log)

2012-09-07 Initial Import
    [VA2EPR-TNC.DSN, VA2EPR-TNC.LYT, VA2EPR-TNC.SDF]
2012-09-10 Add SRAM and make more custom footprints.
    [VA2EPR-TNC.DSN, VA2EPR-TNC.LYT, VA2EPR-TNC.SDF]
2012-09-10 Move DAC to PORTA to free up SPI bus pins for SRAM
2012-09-13 Remove SRAM from schematic, PCB, etc.
    [VA2EPR-TNC.DSN, VA2EPR-TNC.LYT]
2012-09-13 no longer needed
    [VA2EPR-TNC.SDF]
2012-09-13 website updates -- add schematic, bill of materials, text, etc
2012-09-13 rename materials and schematic file
2012-09-13 Fix some packaging errors.
    [VA2EPR-TNC.DSN, VA2EPR-TNC.LYT, VA2EPR-TNC.SDF]
2012-09-14 Increase table of sinewave samples to 32 samples (from 16). Need to see it on a scope.
2012-09-19 PCB Layout
    [VA2EPR-TNC.DSN, VA2EPR-TNC.LYT, VA2EPR-TNC.SDF]
2012-09-23 Website Updates (add CAD and gerber files)
    [VA2EPR-TNC.DSN, VA2EPR-TNC.LYT]
2012-09-27 Add cable drawing
    [va2epr-tnc-cables.DSN]
2012-10-11 Update spec with enclosure size
2012-10-11 Slight changes after building first prototype. More work needs to be done here.
2012-10-12 First Draft of Rev B
    [VA2EPR-TNC.DSN, VA2EPR-TNC.LYT, VA2EPR-TNC.SDF]
2012-10-16 Add a potentiometer. Make some layout tweaks.
    [VA2EPR-TNC.DSN, VA2EPR-TNC.LYT, VA2EPR-TNC.SDF]
2012-10-17 More work on Rev B
    [VA2EPR-TNC.DSN, VA2EPR-TNC.LYT, VA2EPR-TNC.SDF]
2012-10-17 Refresh with some Rev B files. Still need to generate GERBERs for rev B
    [VA2EPR-TNC.DSN, VA2EPR-TNC.LYT]
2012-10-17 rev B schematic
2012-10-24 Add read/write fuses target. Test on Linux.
2012-10-29 Refresh GERBER files for Rev B board.
2012-10-31 Fix status bar, add tabs.
    [va2epr_tnc.cpp, va2epr_tnc.h]
2012-11-01 Add OpenLayers and skeleton Console widget
    [config.cfg, node-tests.cfg]
2012-11-02 Internationalization has been cleaned up and works now.
    Just need to add some translations ;) Currently only the 'Send'
    button is translated (and probably badly). To test, just run
    ./build.sh and then start ./va2epr-tnc with LANG set to fr.
    $ LANG=fr ./va2epr-tnc
2012-11-02 Switch to hosted OpenLayers
    This is better than keeping a local copy because the hosted
    version can always be the latest and greatest. It also reduces
    the installation size and solves the problem of where to put
    the html and javascript files on each target OS. The only downside
    is that it increases the start up time (~7 seconds to get a fully
    loaded map, up from ~5 seconds).
    [config.cfg, node-tests.cfg]
2012-11-07 Rev B DAC is wired backwards. Can fix in SW
2012-11-07 regenerate sine wave table for backwards DAC connection in Rev B board
2012-11-09 Possible bug fix, probable optimization
    [afsk.c]
2012-11-29 Increase baud rate of UART interface.
    Doing this to speed up AFSK RX code. Buffering will probably
    fix the timing issue.
    [kiss.h]
2013-02-12 Settings.cpp: fix tr() calls.
    [Settings.cpp]
2013-02-12 va2epr_tnc.cpp: remove TODO items that are no longer valid
    [va2epr_tnc.cpp]
2013-02-18 Update V2 Notes (add power save)
2013-02-26 first past at APRS frame headers and trailers.
2013-04-09 Add function prototype for markerAdd()
2013-04-09 Fix index out of bounds error.
    [ConnectDialog.cpp]
2013-04-10 Label out going uart data.
2013-04-10 Enhance for new device<->PC protocol
2013-04-29 aprs.c: Fix formatting of messages to match parser.
    [aprs.c]
2013-04-29 uart.c: wait until send buffer is empty before sending.
